Sphaeralcea/Breadboard_Buddy/PCBPicture.jpg

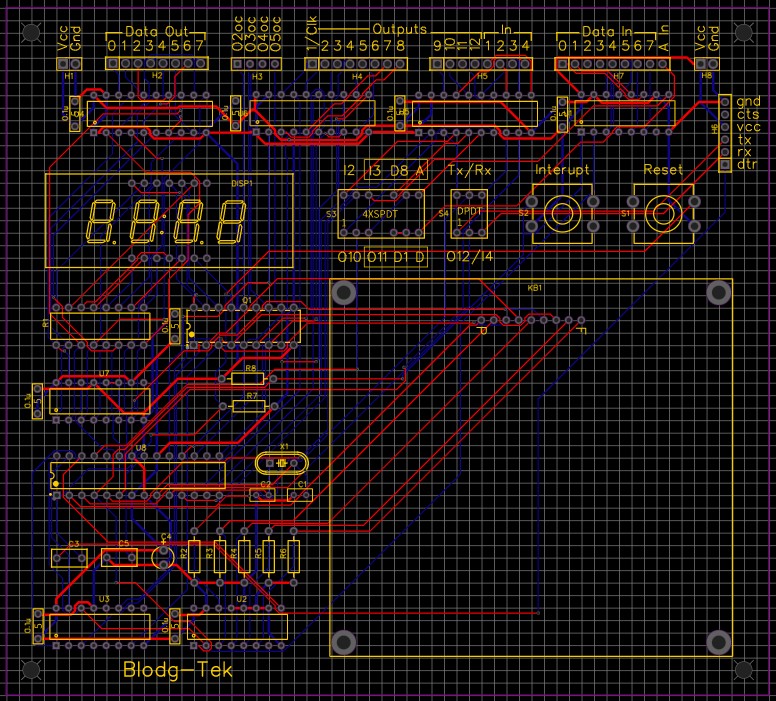
PCBPicture.jpg
