Sphaeralcea/Breadboard_Buddy/TopView.jpg

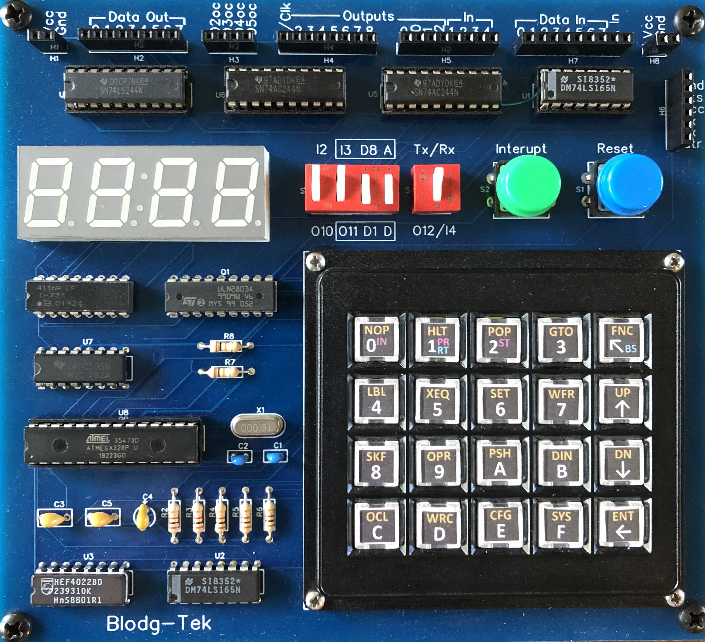
TopView.jpg
