Sphaeralcea/Breadboard_Buddy/BreadBoardBuddy.pptx

Keyboard Cheat Sheet

Underlined commands function interactively
Clock advances on these instructions, if enabled

0 NOP | 1 HALT RTN | 2 POP² [0,1,2,B,D,E,F] | 3 GOTO [0..F] | FNC¹ -Mode Switch -Backspace
4 LBL [0..F] | 5 XEQ [0..F] | 6 SET [1..C] [0,1] | 7 WFOR³ [1..4,E] [0,1] | UP
8 SKIF³ [1..4,B..F] [0,1] | 9 OPR⁴ [0..B] | A PUSH [00..FF] | B DIN⁵ [0..6,8,B,E,F] | DN
C OCEL [0..F] [0..F] | D WRC⁶ [0..F] | E CFG⁷ [0..F] [0..F] | F SYS⁸ [00..FF] | ENT

⁸Sys Cmd | Op | Push Args
VM Dump | 00
Stack Dump | 01
Save Page | 02 | <1-4>
Restore Page | 03 | <1-4>
Save Stack | 04 | <1-4>
Restore Stack | 05 | <1-4>
Disp Literal | 10 | 4{00-FF}
Disp Hex | 11 | <00-FF>
Disp Long Hex | 12 | 2{00-FF}
Insert Time Delay (ms) | 13 | <00-FF>
Disp Duration (x100ms) | 14 | <00-FF>
Disp “HErE” and hang | 15
Disp “----” | 16
Disp TOS (Hex) | 17
Serial Byte Tx | 20 | <00-FF>
Serial Byte Rx | 21
RS232 Baud | 22 | <1,2,4,8,10,20>¹
RS232 Data Available | 23
RS232 Byte Tx | 24 | <00-FF>
RS232 Byte Rx | 25
Console String Rx | 26
SW232 Baud | 27 | <1,2,4,8,10,20>¹
SW232 Tx | 29 | <00-FF>
SW232 Rx | 2A
I2C Byte Tx | 2B | 3{00-FF}
I2C Byte Rx | 2C | 2{00-FF}
SPI Byte Tx | 2D | <00-FF>
SPI Byte Rx | 2E
1-Wire Byte Tx | 2F | <00-FF>
1-Wire Byte Rx | 30 | <00-FF>
Config PWM | 40 | <3-5,8,9> <00-FF>
Measr/Disp Vcc (mv) | 41
Test: Clk Freq | F0 | 4{00-FF}
Test: ADC w/1.1V Ref | F1
Disp Rev Num | FF

¹Baud Rates
1 | 2 | 3 | 8 | 10 | 20
300 | 600 | 1200 | 2400 | 4800 | 9600

⁶Arc Row
0 | Always
1 | In1
2 | In2
3 | In3
4 | In4
5 | EQ
6 | GT
7 | ClkCnt==0
8 | LT
9 | In1#
A | In2#
B | In3#
C | In4#
D | EQ#
E | GT#
F | ClkCnt!=0

⁷Cfg Reg | Num | Value
Sys Clk Per | 0 | 0: Disable 1,2,3: 1,2,5 ms 5,6,7: 10,20,50 ms 9,A,B: 100,200,500 ms D,E,F: 1,2,5 sec
XEQ Mode | 1 | 0: Linear 1: FSM (state machine)
I2/O10¹ | 2 | 0: I2 1: O10
I3/O11¹ | 3 | 0: I3 1: O11
I4/O12¹ | 4 | 0: Tx/Rx 1: I4/O12
I3 D Mode¹ | 5 | 0: 1 Bit 1: 8 bit D 2: 8 bit A
Bin Cntr²,³ | 6 | 0: Disable 2-8: 2-8 bit
IRQ En⁴,⁵ | 7 | 0: Disable 1: Enable IRQ In1
Brk Pt En⁶ | 8 | 0: Disable 1: Enable

¹Observe Switch Settings
²Increments on POP 2
³Cnt[7:0]=>O[7,8,9,2,3,4,5,6]
⁴ISR subroutine at LBL F
⁵IRQ type (edge) will be at TOS
⁶Brk Pt address set with POP D

⁵Din Source
0 | 8bit D or A
1 | In1
2 | In2
3 | In3
4 | In4
5 | ΔT R32us¹
6 | ΔT R8.192ms²
8 | Copy TOS
9 | Bin Out Cntr
B | Loop2 Cntr
E | State Cntr
F | Loop1 Cntr

¹Functions (Modes)
FNC-0 | Interactive
FNC-1 | Program
FNC-2 | Stack Review
FNC-3 | View Address
Fnc2-ENT¹ | Backspace

¹Fnc2 initiated when FNC key pressed during a key sequence

²Pop Target
0 | Bit Bucket
1 | Data Output
2 | DOut+Cntr
B | Loop2 Cntr²
D | Brk Pt Addr
B | Loop2 Cntr²
E | State Cntr¹
F | Loop1 Cntr²

¹Decr’s on instr
²Decr’s on skif

³Skif/Wfor Test
1 | In1
2 | In2 (ΔT)
3 | In3
4 | In4
C | GT (skif)
D | EQ (skif)
B | Loop2 Cntr (skif)
E | State Cntr
F | Loop1 Cntr (skif)

⁴Operator
0 | TST
1 | TSTZ
2 | ADD
3 | SUB
4 | INCR
5 | DECR
6 | AND
7 | OR
8 | XOR
9 | NOT
A | SHL
B | SHR

¹Time difference between consecutive WFOR events on I2; 32-4096us range
²Time difference between consecutive WFOR events on I2; 8.192-1050ms range

## Slide 2

Program Modules/Virtual Machine Architecture

Kybd/Disp Driver

Cmd Assembler

Keyboard Accumulator

Display Buffer

Execute Loop

XEQ Loop (min) = 28.2us
PgmInt adds 6.2us

Label Array

Label0

<pgmAddr>

LabelF

Virtual Machine Data Structure

Rtn Ptr

<pgmAddr>

Call Stack[16]

Pgm Cntr

3x85
Byte
Pgm
Mem

:

:

Stack Ptr

256
Byte
Stack

Pgm Pause

Pgm Running

XEQ Level

Loop1 Cnt

Do(7:0)

O1

clk

0

O2:O9

counter

IRQ

I1

I2O10

Signal I/F

wfor(1:4)

WFor

I1-I4

I3O11

I3

cfg reg num

I4RX

I4

Rx

O12

TX

:
:

= Flag

Loop2 Cnt

State Cnt

> Flag

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
BrkPt Ptr

8

0
1
:
:
F

Cfg Regs

State[16]

Orow

Ocol

WRC

16x16 State
Table Cells

I1

DI(7:0)

O12

Nonvolatile Code/Data Store

4X256 Byte Pages

Arc[16]

FSM

DO(7:0)

Counter Bit | 7 | 6 | 5 | 4 | 3 | 2 | 1 | 0
Output Sig | O7 | O8 | O9 | O2 | O3 | O4 | O5 | O6

O1

O2-O9

O10

I1-I4

O11

A

Tx

1

## Slide 3

Hardware

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
ATMEL328

SData

A0

74hc595

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
Coli

A3

Ld

P2

Clk

A5

Rrst

A4

SClk

A1

Int

74hc165

D E F G H

Ld

CD4022

0 1 2 3 4

ULN2803

I3d8

I3d8

Pin Reg Signal
2 - P0 - D0 – Rx/I4
3 - P1 - D1 – Tx/O12
25 - A2 - C2 – I3/O11
5 - P3 ~ D3 – I2/O10
6 - P4 - D4 – I1
11 - P5 ~ D5 – O9
12 - P6 ~ D6 – O8
13 - P7 - D7 – O7
14 - P8 - B0 – O6
15 - P9 ~ B1 – O5
16 - P10 ~ B2 – O4
17 - P11 ~ B3 – O3
18 - P12 - B4 – O2
19 - P13 - B5 – O1/Clk
23 - A0 - C0 – SDat
24 - A1 - C1 – SClk
4 - P2 - D2 – Cld
26 - A3 - C3 – COLi
27 - A4 - C4 – Rrst
28 - A5 - C5 – RCclk

74hc244

74hc244

74hc165

Ld

74hc244

Key Assignment

Configurable
I/O or Rx/Tx

Hard Outputs

Ain

DataI[7:0]

DataO[7:0]

0 | 1 | 2 | 3 | Func
4 | 5 | 6 | 7 | Up
8 | 9 | A | B | Down
C | D | E | F | Enter

Configurable
input or output

Hard Input

Open Collector Sigs O2oc-O5oc

## Slide 4

Finite State Machine Execution

In FSM execution mode, a routine must be defined for each programmed state with a start label number corresponding to the state such that the state action at each state is performed by a routine starting with a label corresponding to the state number. So if state table location 5,2 indicates a transition to state 3, a routine starting with label 3 must be supplied for the action in state 3.
The example FSM requires 5 routines labeled 1,2,3,4,5 respectively, State 5 is the terminal state of the FSM. It has no transition but it still needs an action routine with label 5 which must include instruction ENB 1 0, to terminate FSM execution mode.

1

I2=1

Tst=0

Tst=1

always

2

In4=0

3

In4=1

4

5

The state machine transition table must be programmed into the VMs FSM table using OCEL and WRC instructions.

FSM Mode Execution Algorithm
Set initial state - See start of XEQ code
Enable FSM mode
While FSM enabled
Execute routine at label <currentstate>
Look up new <currentstate>

FSM Next State Lookup - See HALT code
Foreach row cell in FSM column <currentstate>
If cell is nonzero*, // cell filled with a next state
If arc evaluation is True
nextstate = FSMtable[arc][currstate]
Else
Continue

*While state 0 can be the initial state, it cannot be a destination state since 0 is the null state number that the FSM lookup passes over.

OCOL

0 1 2 3 4 5 6 7 8 9 A B C D E F

Always 0

I1=1 1

I2=1 2

I3=1 3

I4=1 4

Equ=1 5

GT=1 6

ClkCnt=0 7

LT=1 8

I1=0 9

I2=0 A

I3=0 B

I4=0 C

Equ=0 D

GT=0 E

ClkCnt!=0 F

2

4

1

3

5

4

LT is virtual bit (GT=0 && Equ=0)

Arcs Row

States

OROW

OCEL <row><col>: OCEL instruction fills OROW and OCOL registers with address of FSM cell that can be written to with the WRC instruction

WRC <state>: Fills the FSM cell addressed by OROW and OCOL

CFG <1><1>: Writes a 1 to the FSM enable register, enabling FSM execution mode.

## Slide 5

Virtual Machine Instruction Set

Instruction | Acc0 | Acc1 | Acc2 | Description | Clks | Notes
NOP | 0 | | | No Operation | 93 | 1
HALT | 1 | | | Terminate a program or subroutine | | 2
POP <destination> | 2 | 0 | | Pop to Bit Bucket | 101
| | 1 | | Pop to 8 bit Data Output | 828 | 1
| | E | | Pop to VM State Counter | 105
| | F | | Pop to VM Loop Counter | 108
GOTO <label> | 3 | 0..F | | Unconditionally Jump to Label 0..F | 97
LBL <literal> | 4 | 0..F | | Declare a Label 0..F That Begins a Program or Subroutine or Defines a Branch Target Within a Program | 89
XEQ <label> | 5 | 0..F | | Execute Program or Subroutine at Label 0..F | 110 | 3
SET <signal><value> | 6 | 1..C | 0,1 | Set Output 1..C to 0 or 1 | 126/128 | 1
WFOR <object><value> | 7 | 1 | 0,1 | Wait For Input Signal 1 to be 0 or 1 | | 1
| | 2 | | Wait For Input Signal 2 to be 0 or 1 | | 1,4
| | 3 | | Wait For Input Signal 3 to be 0 or 1 | | 1
| | 4 | | Wait For Input Signal 4 to be 0 or 1 | | 1
| | F | | Wait for the Loop Counter to Count Down to 0 or 1 | | 1
SKIF <object><value> | 8 | 1 | 0,1 | Skip Next Instruction if Input Signal 1 is 0 or 1 | 127 | 1
| | 2 | | Skip Next Instruction if Input Signal 2 is 0 or 1 | 127 | 1
| | 3 | | Skip Next Instruction if Input Signal 3 is 0 or 1 | 127 | 1
| | 4 | | Skip Next Instruction if Input Signal 4 is 0 or 1 | 142 | 1
| | C | | Skip Next Instruction if Greater Than Flag is 0 or 1 | 122 | 1
| | D | | Skip Next Instruction if Equal Flag is 0 or 1 | 122 | 1
| | E | | Skip Next Instruction if State Counter is 0 or 1 | 122 | 1
| | F | | Skip Next Instruction if Loop Counter is 0 or 1 | 129 | 1

Instruction | Acc0 | Acc1 | Acc2 | Description | Clks | Notes
OPR <operation> | 9 | 0 | | TST: Pop TOS and Test with NOS, Set GRT and EQU Flags | 136
| | 1 | | ADD: Pop TOS and Add to NOS | 130
| | 2 | | SUB: Pop TOS and Subtract to NOS | 130
| | 5 | | AND: Pop TOS and AND With NOS | 132
| | 6 | | OR: Pop TOS and OR with NOS | 132
| | 7 | | XOR: Pop TOS and XOR with NOS | 132
| | 9 | | SHL: Shift TOS One Bit to the Left (No Pop) | 124
| | A | | SHR: Shift TOS One Bit to the Right (No Pop) | 126
PUSH <literal byte> | A | 0..F | 0..F | Push Immediate Byte 00..FF on Stack | 106
DIN <source> | B | 0 | | Input 8 bits (D or A) and Push to Stack | 126/2000 | 1,5
| | 1 | | Left Shift the Value of Input 1 to TOS (No Push) | 136 | 1,6
| | 2 | | Left Shift the Value of Input 2 to TOS (No Push) | 137 | 1,6
| | 3 | | Left Shift the Value of Input 3 to TOS (No Push) | 137 | 1,6
| | 4 | | Left Shift the Value of Input 4 to TOS (No Push) | 135 | 1,6
| | 5 | | Push Time Stamp Difference (32us - 4.1ms Range) | 177 | 4
| | 6 | | Push Time Stamp Difference (8.192ms - 1.05s Range) | 233 | 4
| | E | | Push State Counter onto Stack | 124
| | F | | Push Loop Counter onto Stack | 124
OCEL <row><col> | C | 0..F | 0..F | Open State Table Cell at Row 0..F and Column 0..F to Fill
WCEL <state> | D | 0..F | | Fill Next State Value 0..F Into Open State Table Cell
CFG <target><value> | E | 0..6 | 0..F | Set Virtual Config Register 0..6 to a Value 0..F | 124
SYS <function number> | F | 0..F | 0..F | Execute System Function 00..FF

1. Advances System Clk
2. Halt execution if program level > 1, return from subroutine otherwise
3. Execute as main program if program level < 1, execute as subroutine otherwise
4. Input 2 registers a time stamp on each satisfied WFOR (on input 2) allowing the difference between two consecutive time stamps to be measured. These are used by DIN sub opcodes 5 and 6.
5. 8 bit inputs are assembled from Input 3 configured as either 8 bit digital or 8 bit analog input
6. Typically first use of a 1 bit DIN is preceded by pushing 0x00 on to stack to shift results into

## Slide 6

HW/SW Configuration Switches

Configuration | Register | Value | Switch Pos
Sys Clk | 0 | 0: Disabled 1: 1ms 2: 2ms 3: 5ms 5: 10ms 6: 20ms 7: 50ms 9: 100ms A: 200ms B: 500ms D: 1s E: 2s F: 5s | X
SM Mode | 1 | 0: Normal 1: SM Mode | X
I2/O10 | 2 | 0: I2 1: O10 | I2 O10
I3/O11 | 3 | 0: I3 1: O11 | I3 O11
I3 Data Type | 5 | 0: 1 Bit 1: 8 bit dig 2: 8 bit ana | D, D1 D, D8 A, D8
I4/O12 | 4 | 0: Tx/Rx 1: I4/O12 | Tx/Rx O12/I4
Counter | 6 | 0: Disabled 2: 2 bit : 8: 8 bit | X

O9
11/P5/D5

LS244

O9

O10

O11

O12

I1
6/P4/D4

O10/I2
5/P3/D3

C1

I1

O11/I3
25/A2/C2

C2

I2

I4

I3

I4/Tx
2/P0/D0/rx

C1

4XSPDT

Tx (FTDI Tx pin)

O12/Rx
3/P1/D1/tx

C2

Rx (FTDI Rx pin)

1XDPDT

C3

C4

ls165

8

Din

Ain

Configuration of I2/O10, I3/O11, and I4/O12 require proper Switch configuration and Software configuration

## Slide 7

KEYBOARD STATE MACHINE (Mode=Normal/Interactive)

0 | 1 | 2 | 3 | func
4 | 5 | 6 | 7 | ^
8 | 9 | A | B | v
C | D | E | F | enter

State | Action
Idle | Nop; clear dispbuf
OP-* | Accumulate opcode; put “<op>-“ in dispbuff[0,1]
FUNC | Set FUNC bit. Put “-“ in dispbuf[0]
LBL | Accumulate operand; put operand in dispbuf[2]
LVL NBL1 | Accumulate operand; put operand in dispbuf[2]
SIG WFS NBL2 | Accumulate operand; put operand in dispbuf[3]
PROG | Set Prog; put prgmem[pgmcntr] into dispbuf
STKREV | Set Stkrev; put stk[stkptr] into dispbuf
TERM | Pass accumulator to scheduler; clear dispbuf
FUNC2 | Set Func bit
BS | Dispptr--, acumptr--, state=pop(statestack)
Default Error | Nop; put “Eror” in dispbuf, goto Idle

OP-0

Op-0

ENTER

LBL

TERM

ENTER

ENTER

ENTER

Symbol | Lex
NULL | 0
HALT | 1
POP | 2
GOTO | 3
LBL | 4
XEQ | 5
SET | 6
WAITFOR | 7
SKPIF | 8
OPR | 9
PUSH | A
IN | B
OCEL | C
WRS | D
CFG | E
SYS | F
NORM | 0
PROG | 1
STKREV | 2
ADDR | 3
OP-0 | HALT, NULL
OP-1 | GOTO, XEQ, LBL, POP, DIN, WRC
OP-2o | SET
OP-2i | WAITFOR, SKPIF
OP-D | PUSH, SYS, OCEL, CFG
OP-C | OPR
LBL | 0123456789ABCDEF
LVL | 01
SIG | 123456789ABC
WFS | 1234,F
NBL1/2 | 0123456789ABCDEF
PER | 01235679ABDEF
FUNC | func
UP | ^
DN | v
ENTER | enter
BS | enter

Idle

FUNC

OP-W

OP-D

OP-2

OP-1

Op-1

LBL

ENTER

LVL

Op-2o

SIG

SIG

LVL

Op-2i

WFS

WFS

LVL

LVL

Op-D

NBL

NBL1

NBL

NBL2

Pop state

Push
state

FUNC

FUNC2

BS

ProgSM

ENTER

All Others

ERROR

FUNC

STKREV

ADDR

PROG

PROG

STKREV

ADDR

View current data stack address

StkRevSM

Commands are executed interactively. Stored programs can be executed with XEQ command.

## Slide 8

KEYBOARD STATE MACHINE (Mode=Program)

0 | 1 | 2 | 3 | func
4 | 5 | 6 | 7 | ^
8 | 9 | A | B | v
C | D | E | F | enter

State | Action
Idle | display instruction at pgmcntr
OP-* | Accumulate opcode; put “<op>-“ in dispbuff[0,1]
FUNC | Set FUNC bit. Put “-“ in dispbuf[0]
LBL | Accumulate operand; put operand in dispbuf[2]
LVL NBL1 | Accumulate operand; put operand in dispbuf[2]
SIG WFS NBL2 | Accumulate operand; put operand in dispbuf[3]
NORM | Set Mode=Norm; put “Norm” in dispbuf
ADDR | If Mode==prog, dispbuf=pgmmem[pgmcntr]
STKREV | Set Mode=Stkrev; put “STRV” in dispbuf
FUNC2 | Set Func bit
BS | dispptr--,accumptr--, pop(state stack)
UP | pgmcntr++; dispbuf=prgmem[pgmcntr]
DN | pgmcntr--; dispbuf=prgmem[pgmcntr]
TERM | Pass accumulator to IR
Default Error | Nop; put “Eror” in dispbuf[0-3], goto idle

Idle

OP-1

OP-0

Op-0

ENTER

LBL

ENTER

LVL

TERM

ENTER

Symbol | Lex
NULL | 0
HALT | 1
POP | 2
GOTO | 3
LBL | 4
XEQ | 5
SET | 6
WAITFOR | 7
SKPIF | 8
OPR | 9
PUSH | A
IN | B
OCEL | C
WRS | D
CFG | E
SYS | F
NORM | 0
PROG | 1
STKREV | 2
ADDR | 3
OP-0 | HALT, NULL
OP-1 | GOTO, XEQ, LBL, POP, DIN, WRC
OP-2o | SET
OP-2i | WAITFOR, SKPIF
OP-D | PUSH, SYS, OCEL, CFG
OP-C | OPR
LBL | 0123456789ABCDEF
LVL | 01
SIG | 123456789ABC
WFS | 1234,F
NBL1/2 | 0123456789ABCDEF
PER | 01235679ABDEF
FUNC | func
UP | ^
DN | v
ENTER | enter
BS | enter

OP-W

FUNC

OP-D

OP-2

Op-1

LBL

ENTER

ENTER

Op-2o

SIG

SIG

LVL

Op-2i

WFS

WFS

LVL

LVL

Op-D

Push
state

FUNC

NBL

NBL1

NBL

NBL2

UP

FUNC

FUNC2

ENTER

BS

Pop state

DN

NORM

NORM

NormSM

UP

STKREV

ADDR

ADDR

View current prgm mem addr

DN

STKREV

StkrevSM

All Others

ERROR

Commands are not executed. Commands stored in program memory for later execution. Program memory can be navigated up and down and edited.

## Slide 9

KEYBOARD STATE MACHINE (Mode=Stack Review)

0 | 1 | 2 | 3 | func
4 | 5 | 6 | 7 | ^
8 | 9 | A | B | v
C | D | E | F | enter

State | Action
Idle | Dispbuf = stackPtr+”.”+dStack[stackPtr]
FUNC | Set FUNC bit. Put “-“ in dispbuf[0]
UP | stkptr++; dispbuf=“stackPtr.Data”
DN | stkptr--; dispbuf=“stackPtr.Data”
NBL1 | Clear dispbuf; Accumulate operand; put operand in dispbuf[0]
NBL2 | Accumulate operand; put operand in dispbuf[1]
FUNC2 | Set Func bit
BS | Dispptr--; accumptr--; pop(state stack)
ADDR | If Mode==Stkptr, dispbuf=stack[stkptr]
PROG | Set Prog; display “Prog”
NORM | Set Norm; display=“Norm”
TERM | dStack[stackPtr]=accum; stkptr++; dispbuf=“stackPtr.Data”
Default Error | Nop; put “Eror” in dispbuf[0-3]; goto idle

Idle

NBL1

NBL1

FUNC

NBL2

NBL2

ENTER

LOAD

Symbol | Lex
NORM | 0
PROG | 1
ADDR | 3
NBL1 | 0123456789ABCDEF
NBL2 | 0123456789ABCDEF
FUNC | func
UP | ^
DN | v
LOAD | enter
BS | enter

Push
state

FUNC

BS

UP

FUNC2

PROG

ENTER

Pop state

DN

FUNC

PROG

ProgSM

UP

NORM

ADDR

ADDR

View current data stack address

NORM

ERROR

NormSM

DN

All Others

Navigate up and down the data stack and edit entries.

## Slide 10

Instruction | Pgm Cntr | Test | Data Stack | Internal Var | Operation
NOP | incr | | | | No Operation. If clocks enabled, then one clock executed.
HALT | Stopped or =dStack[--stkPtr] | | | | Permanent inhibit prgmcntr. Required as program terminator. If pgmRunning>1 then it is subroutine return.
POP | incr | | dispDigit(dStack[--stkPtr]) | Loopcnt=dStack[--stkPtr] OR Testflag = (TOS==<val>) | If operand=0, dStack[stkPtr] discarded If operand=1, dStack[stkPtr] shifted into display shift reg and onto data outputs. Increment address counter, if enabled. If operand =2, if dStack[stkPtr] == dStack[stkPtr-1], set tstFlag. If operand=F, dStack[stkPtr] into loop counter.
GOTO | =lbltbl[<val>]+1 | | | | Label is index into label table which returns new program execution address into program counter.
LBL | incr | | | lbltbl[<val>]=pgrmcntr | Store current program counter value in label table indexed by label number. Otherwise behaves like a NOP.
XEQ | =lbltbl[<val>]+1 | | | pgmRunning++ | Execute a program or subroutine. pgmRunning>1 = subroutine.
SET | incr | | | | Write val to sig pin directly.
WFOR | inhibit | sig==val | | waitforen[<sig>]=1 waitfor[<sig>]=<val> Pgmcntren=0 | Inhibit program counter until waitfor condition met Sig I/F loops over the wfsig list. If enable is 1 then test the signal for val and reset enable if true. When no wfsig is enabled, re-enable the pgmcntr.
SKPIF | incr by 1 or 2 | sig==val | | | Live test sig for equality to val. If true, incr pgmcntr by 2, else incr pgmcntr by 1 If sig is “F” then instruction is decrement_and_skip_if [0,1]. Test loop counter for equality to 0 or 1.
OPR | incr | | temp=dStack[--stkPtr] | dStack[stkPtr-1]=temp OPR tos | O1 is used as a dedicated clock signal. Clock enabled when executed. Clkper = some function of val.
PUSH | incr | | dStack[stkPtr++]=<val> | | Push val onto data stack.
DIN | incr | | dStack[stkPtr++]=<In8> OR dStack[stkPtr-1]<<1 | <sig> | | If operand=0, Input data byte is pushed onto stack. If operand=[1,2,3,4], Input data bit is shifted through lsb into TOS.
OCEL | Incr | | | Orow=<val1>, Ocol=<val2> | Sets the address of cell in the FSM that WRC can write to.
WRC | Incr | | | FSMtable[orow][ocol] = <val> | Write a value between 0 and F to the cell referenced in the last OCEL instruction.
CFG | incr | | | <virtual regnum >= <val> | Write a value [0-F] to virtual register [0-F].
SYS | incr | | dStack[--stkPtr] | | Arguments are pushed onto the stack before executing.

Instruction Micro-Ops
