Sphaeralcea/Breadboard_Buddy/KeyBrdClose.JPG

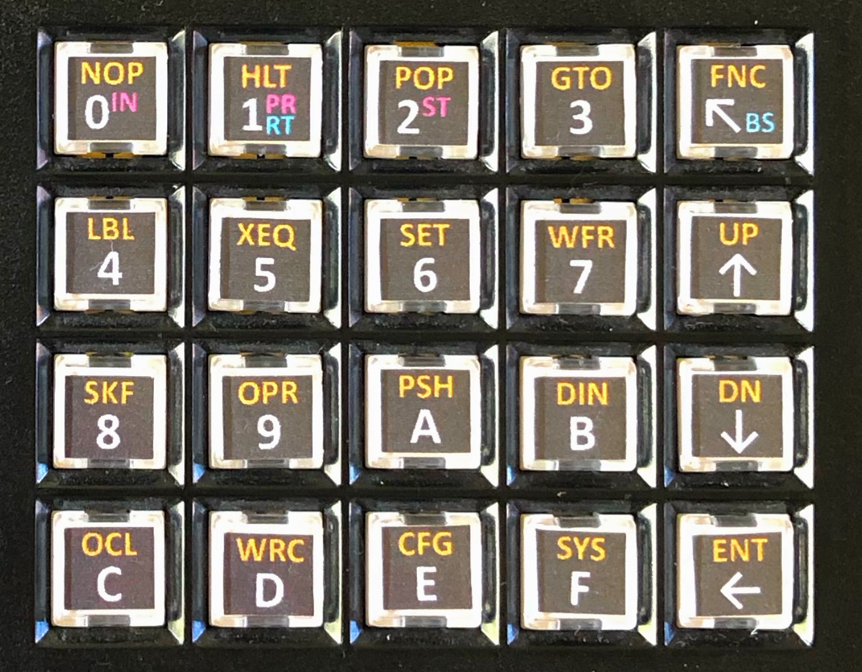
KeyBrdClose.JPG
