Sphaeralcea/Breadboard_Buddy/SchematicPicture.pdf

10 10 11 11 12 12 13 13 14 14 15 15 16 16

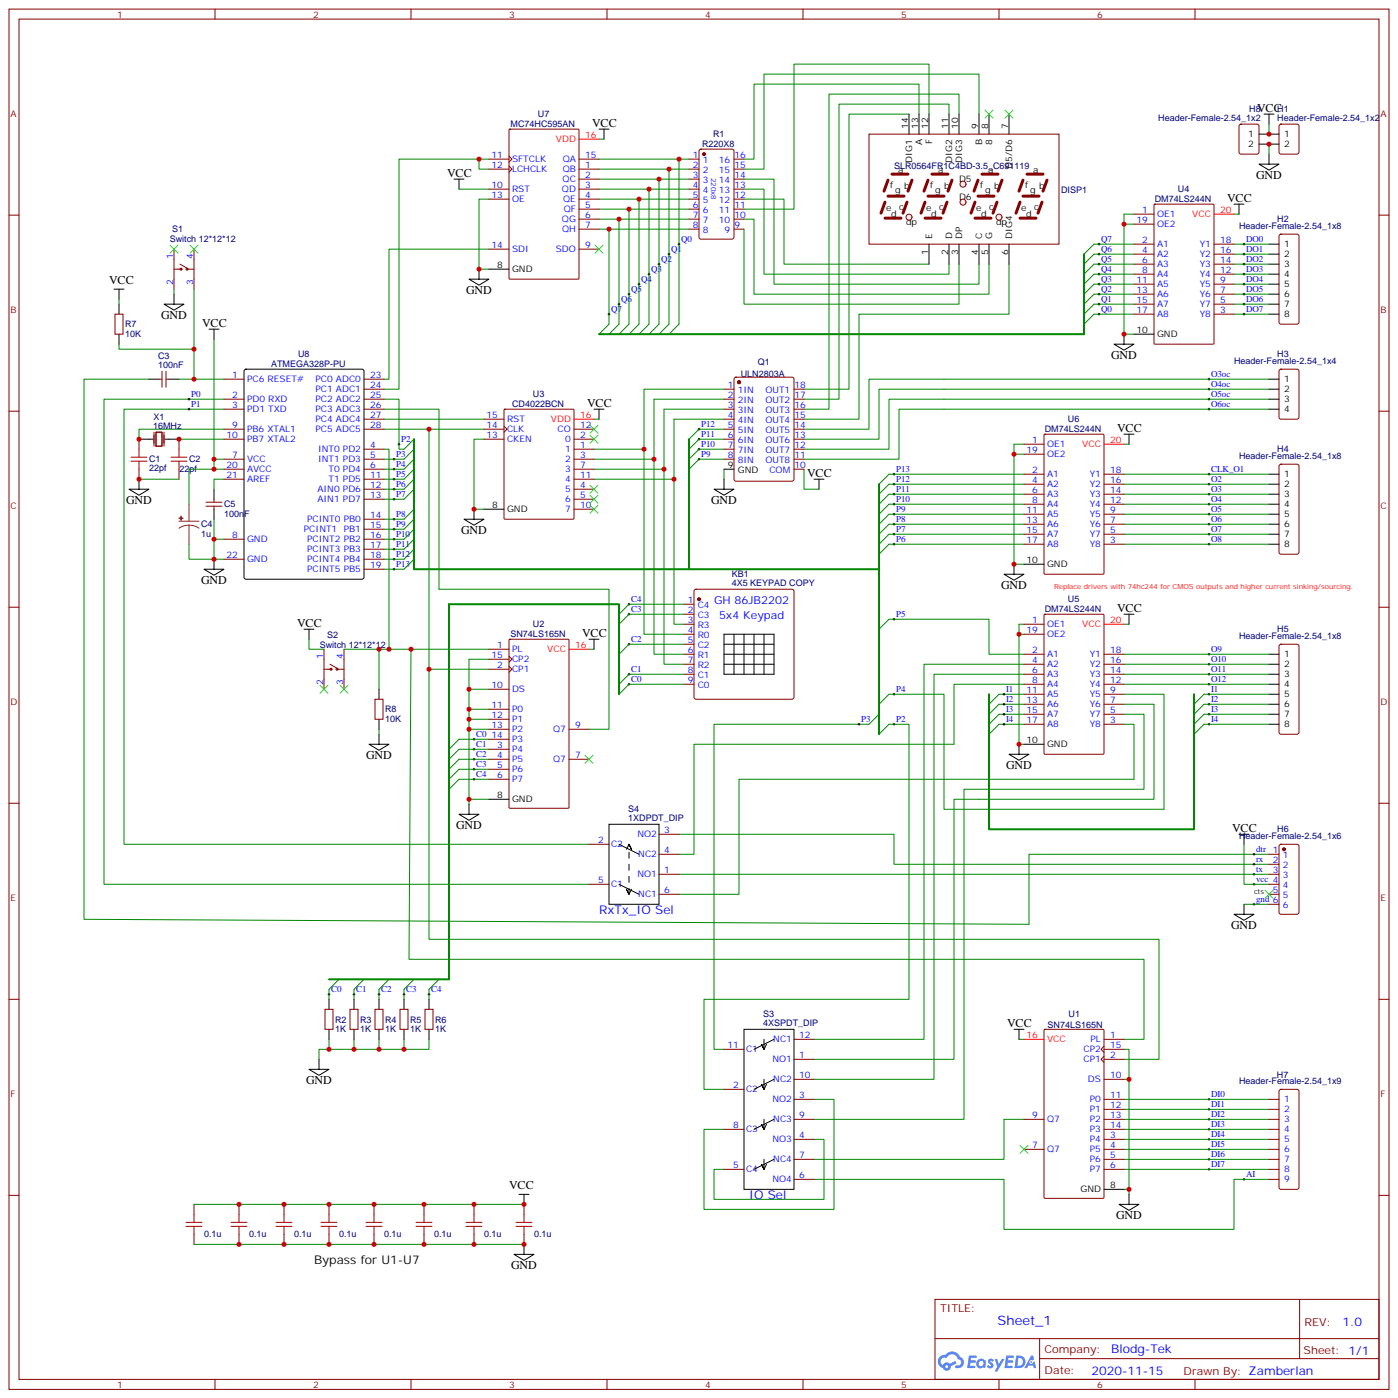
[picture p4: page 1]
